hackergadgets/Lime-AC-Case/Installation Instruction for Lime-AC-Case_Mini.md

# Installation Instruction for Lime-AC-Case: Mini

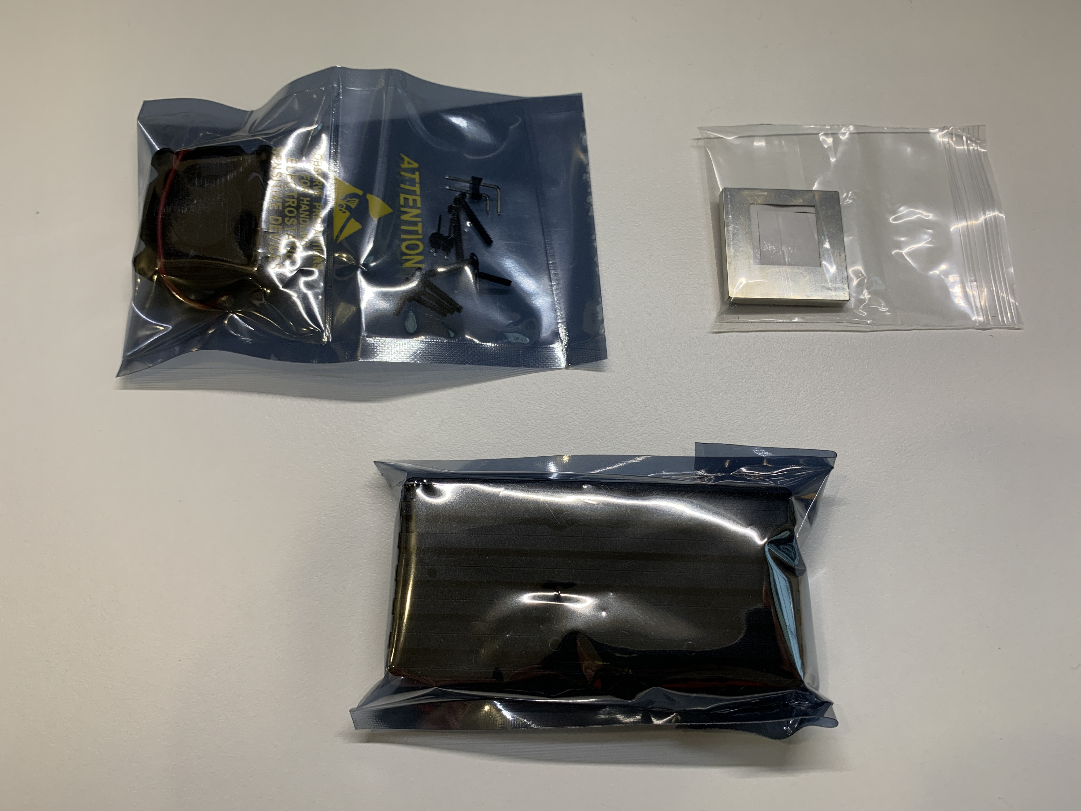
[picture p1: images/mini/IMG_7988.JPG]

Here is what inside the box: fan and screw pack, custom rf shield and foam, case.

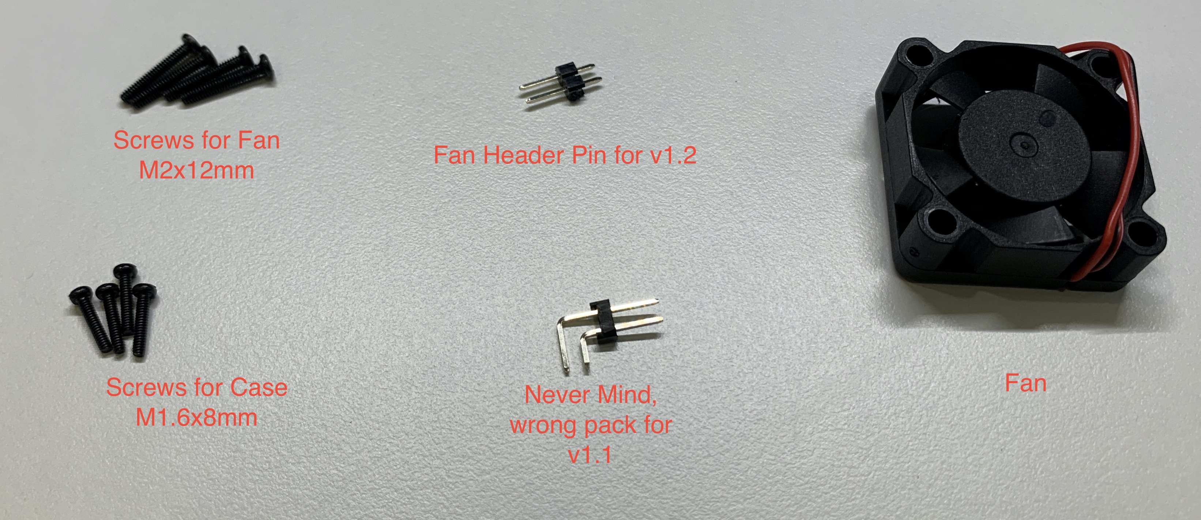
[picture p2: images/mini/IMG_5003.JPG]

Accessories inside the fan and screw pack.

## Preparation.
All you need is just a Phillips PH0 screwdriver. If your board is v1.1 you will need another [2 Position 2.54 mm 1 Row Right Angle Pin (Male) Headers](https://www.mouser.com/ProductDetail/Molex/22-28-6100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) as the fan header pins.

## Step 1: Assemble the RF shield.

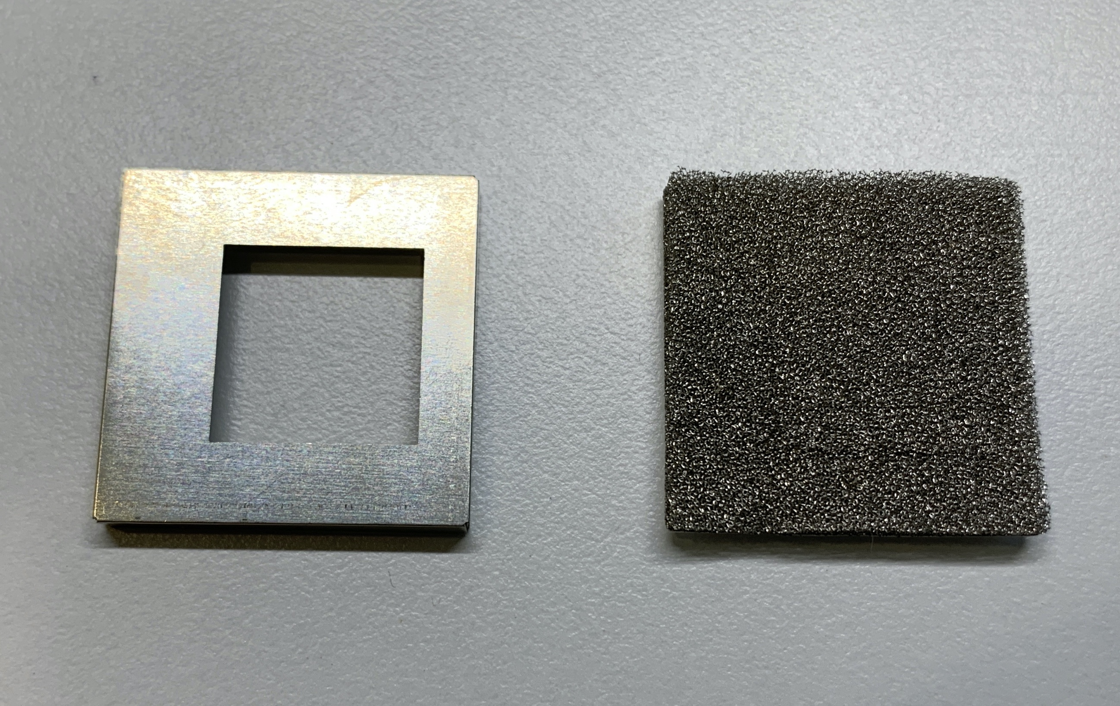
[picture p3: images/mini/IMG_7895.JPG]

Accessories inside the transparent bag.

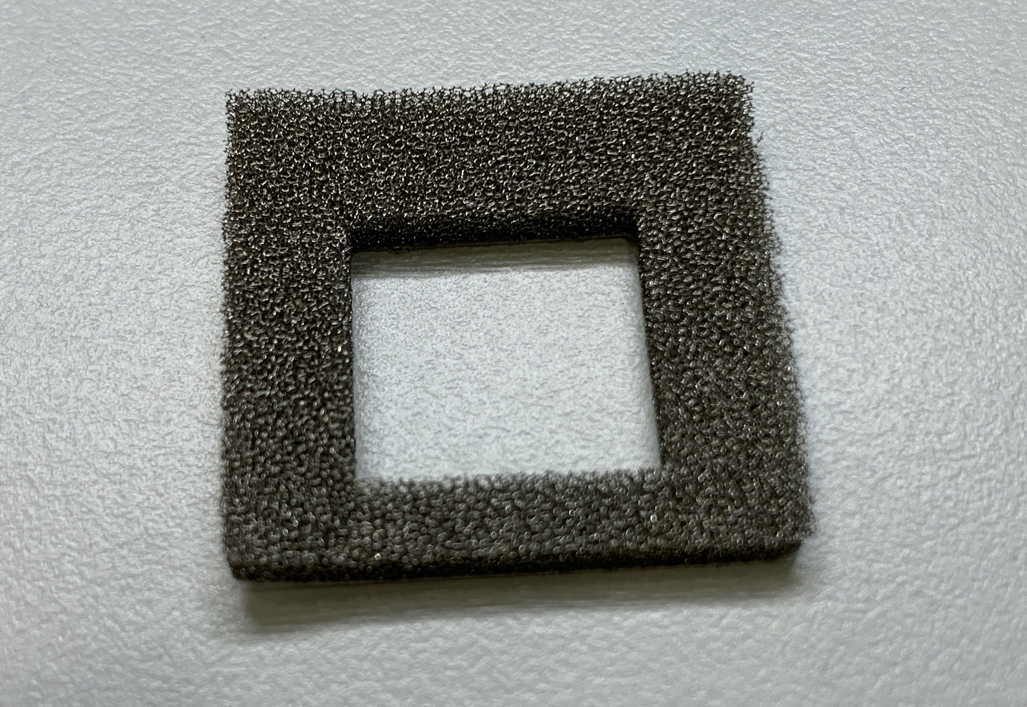
[picture p4: images/mini/IMG_7519.JPG]

First, remove the part inside the foam.

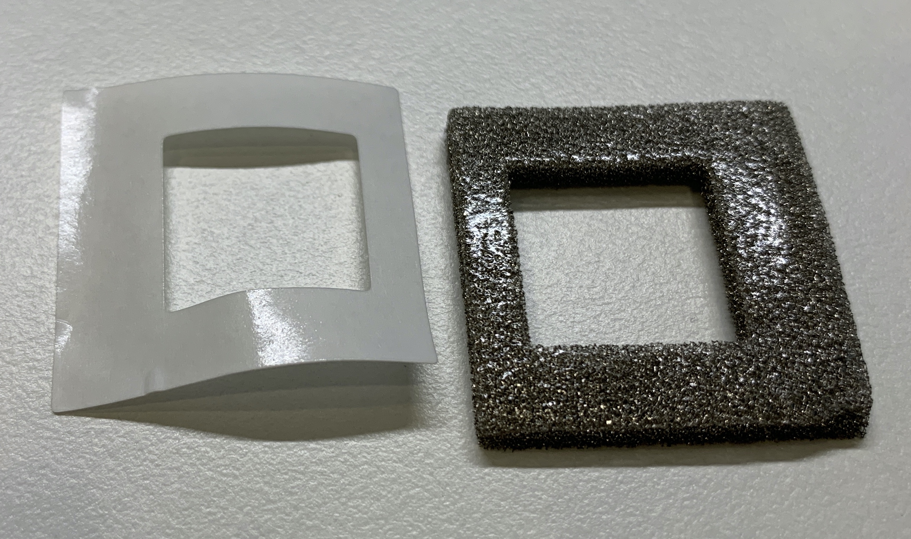
[picture p5: images/mini/IMG_8320.JPG]

Then remove the sticky cover.

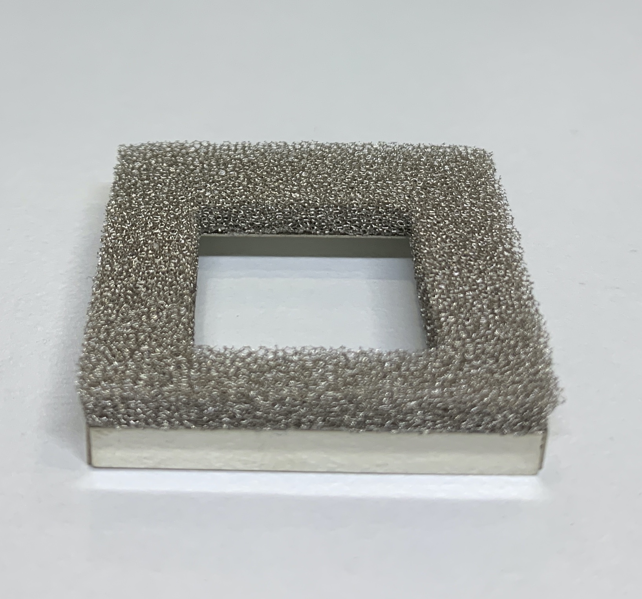
[picture p6: images/mini/IMG_7182.JPG]

Tap the foam on top of the metal shield. **Notice: The hole is not in the center of the foam be aware of the direction.**

## Step 2: Soldering the fan header pins.
**You can skip this step if you don't want the active cooling function.**

Soldering the fan header pin for v1.2 on to the J10 connector on the board, if your board is v1.1 use the [1 Row Right Angle Pin (Male) Headers](https://www.mouser.com/ProductDetail/Molex/22-28-6100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) instead. 

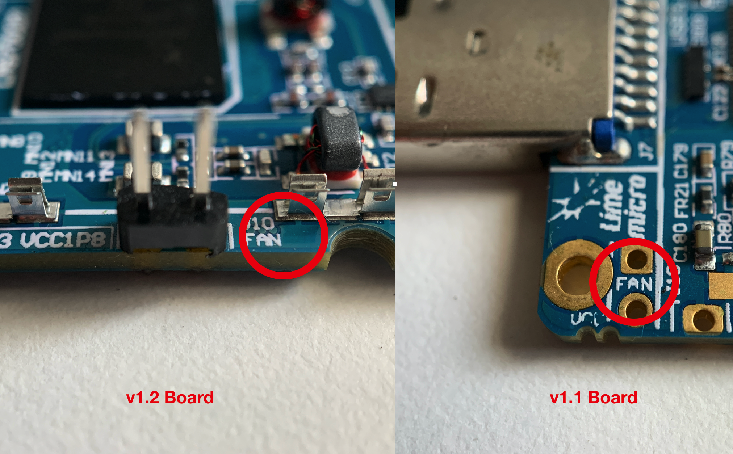
[picture p7: images/mini/IMG_9101.png]

For v1.2 board, the J10 connector is on the edge of the PCB nearby the RF shield, For v1.1 board the connector close to the USB port.

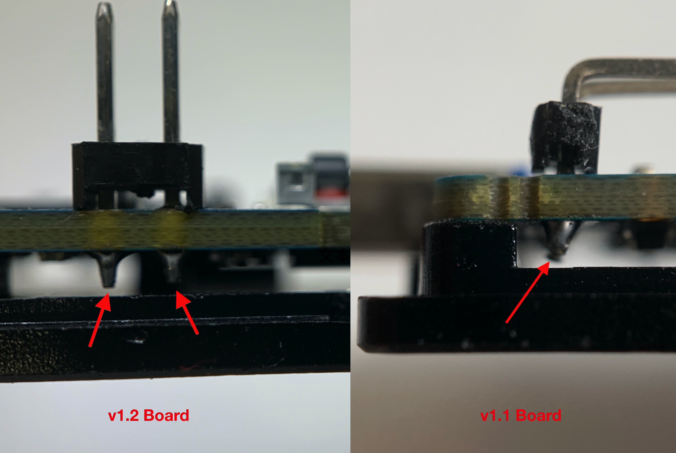
[picture p8: images/mini/IMG_9100.png]

**After soldered use a multi-meter to make sure the two pins are not short. Then combine the board with the bottom case to check if the pins are touching the bottom case or not. If touching the case, cut off the excess or resolder.**


Connect the fan and plug into the USB port to test the fan, if the fan spins, everything works fine, or just check the cable is connecting right.
For the v1.2 board, the pin on the SMA side is positive, for v1.1 board, the positive pin close to the edge.

## Step 3: Install the custom RF shield.

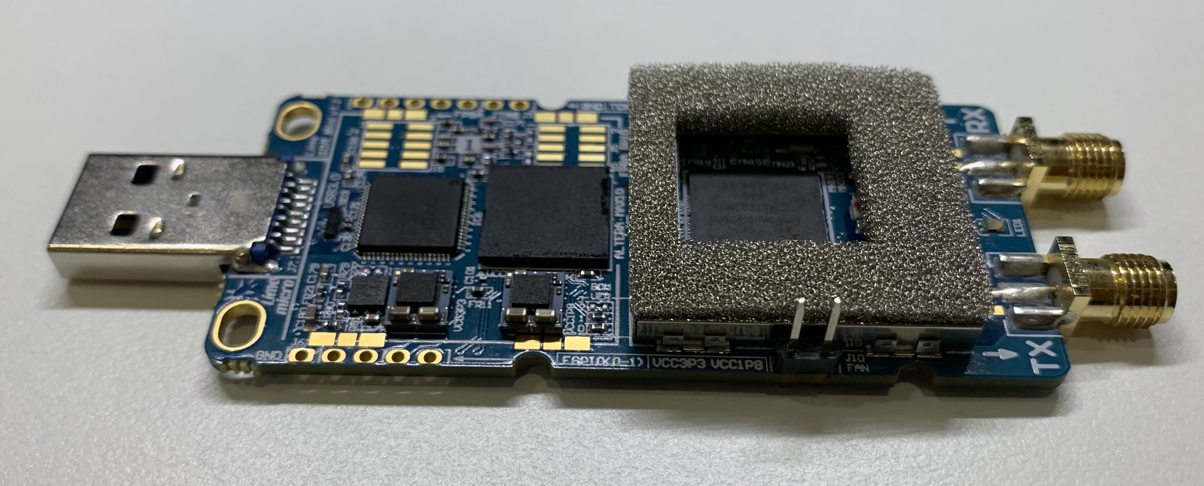
[picture p9: images/mini/IMG_4427.JPG]

Remove the original RF shield and replace it with the custom one. Be aware of the direction, the LMS7002 chip should be in the center of the hole.

## Step 4: Assemble the case.

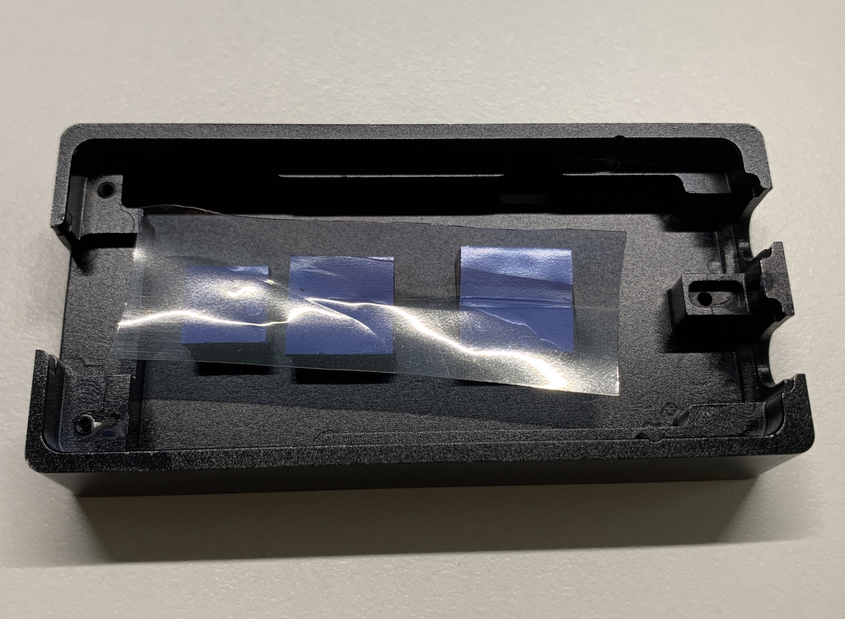
[picture p10: images/mini/IMG_5382.JPG]

Remove the plastic cover that covers the thermal pad.

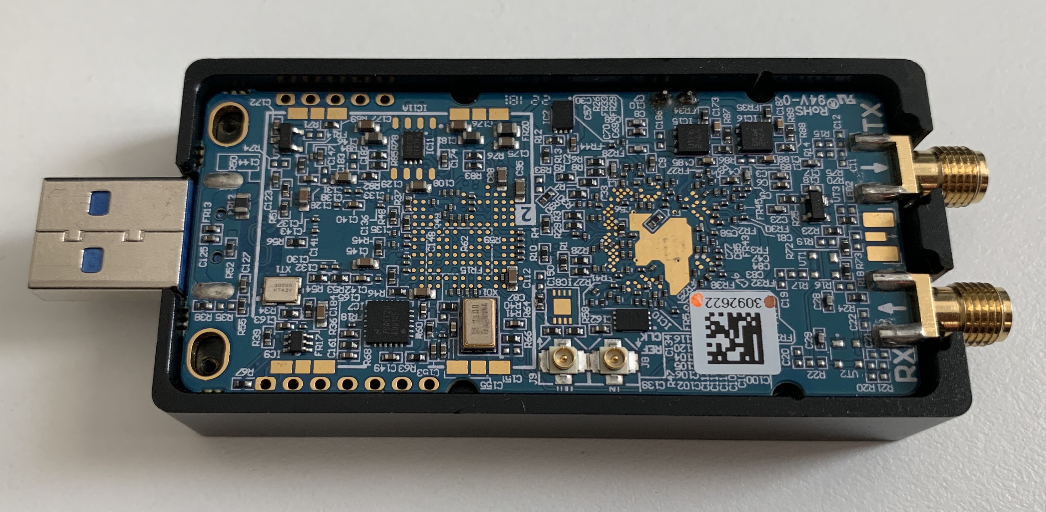
[picture p11: images/mini/IMG_7277.JPG]

Put the board in the top case. For the v1.1 board, you should connect the fan first.

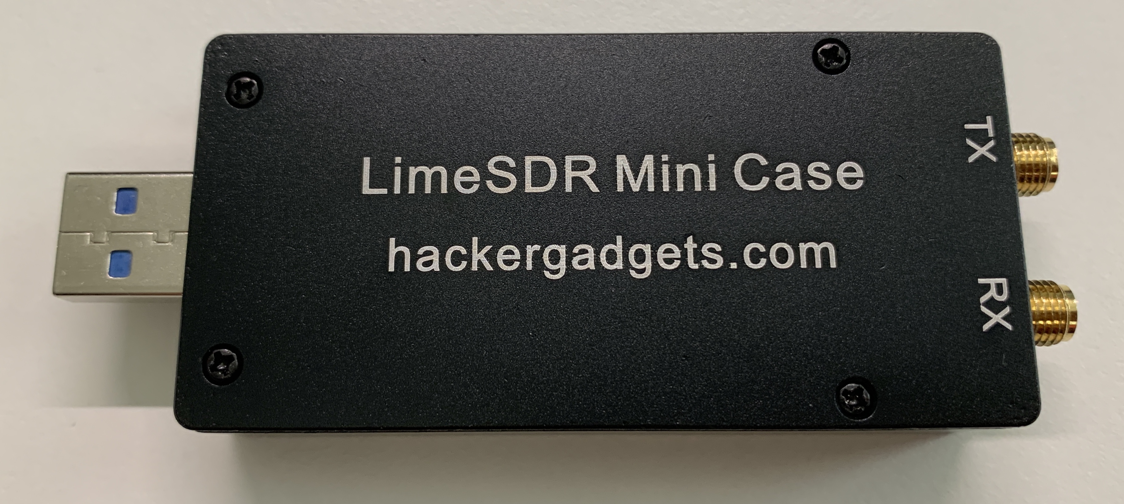
[picture p12: images/mini/IMG_9756.JPG]

Put the bottom on and screw the four M1.6x8mm screws.

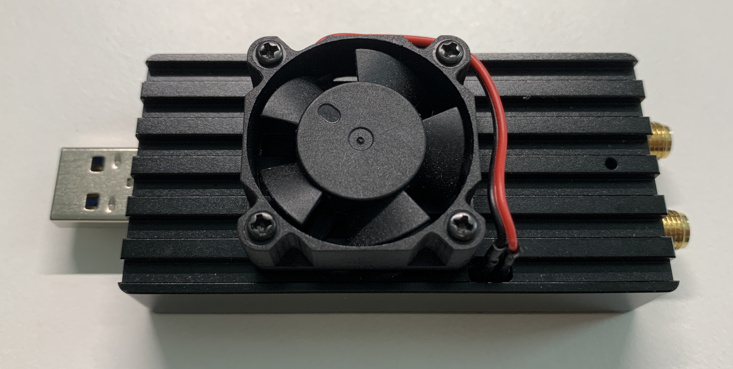
[picture p13: images/mini/IMG_5326.JPG]

Install the fan and secure it with the M2x12mm screws. You can rotate the fan to find the best angle to manage the cable.

### All Finish, have fun with the case.
