hackergadgets/Lime-AC-Case/accessories/Led Indicator v4.stl

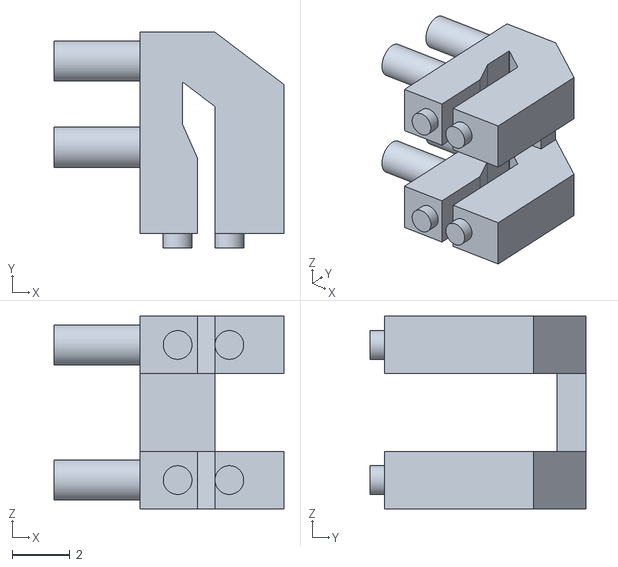
[picture p14: CAD file, 2020-02-22]
accessories/Led Indicator v4.stl
8.00 x 7.50 x 6.70
