hackergadgets/Lime-AC-Case/(threads)

Thread 2 (2021-06-17):

lime ac case mini v1.1   Installation Instruction   ?

kalashnikov2, 2021-06-17:
i have a lime sdr mini v1.1

and get the case v1.1

the Instruction https://github.com/hackergadgets/Lime-AC-Case/blob/master/Installation%20Instruction%20for%20Lime-AC-Case_Mini.md     are not for the case v1.1

have different parts...

in the lime mini v1.1  i have to remove the RFI shield ?  make a hole ?
if i don't remove the RFI shield, how the cable of the fan can go through the conector? ?

which thermal pads i have to use in each ic ?  the thin or the thick ?

in the thermal pads ,which adhesive side should be placed on the IC and which towards the heatsink, blue or white?
